Maxwell-Khor/adhd-medication-reminder/hardware/rev-c/rev-c.kicad_pcb

## KiCad design hardware/rev-c/rev-c.kicad_pcb (2026-03-25)

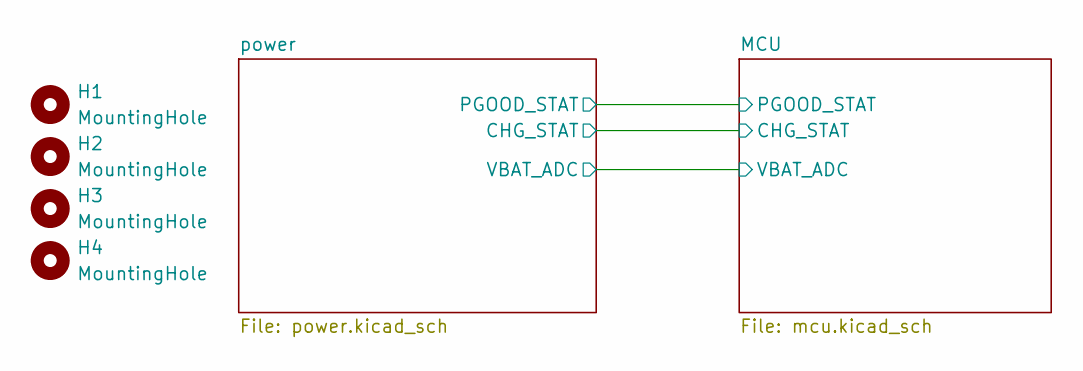
[picture p1: schematic rev-c.kicad_sch, ADHD MEDICATION REMINDER SYSTEM]

Parts:
H1, H2, H3, H4: MountingHole; MountingHole_2.2mm_M2_Pad

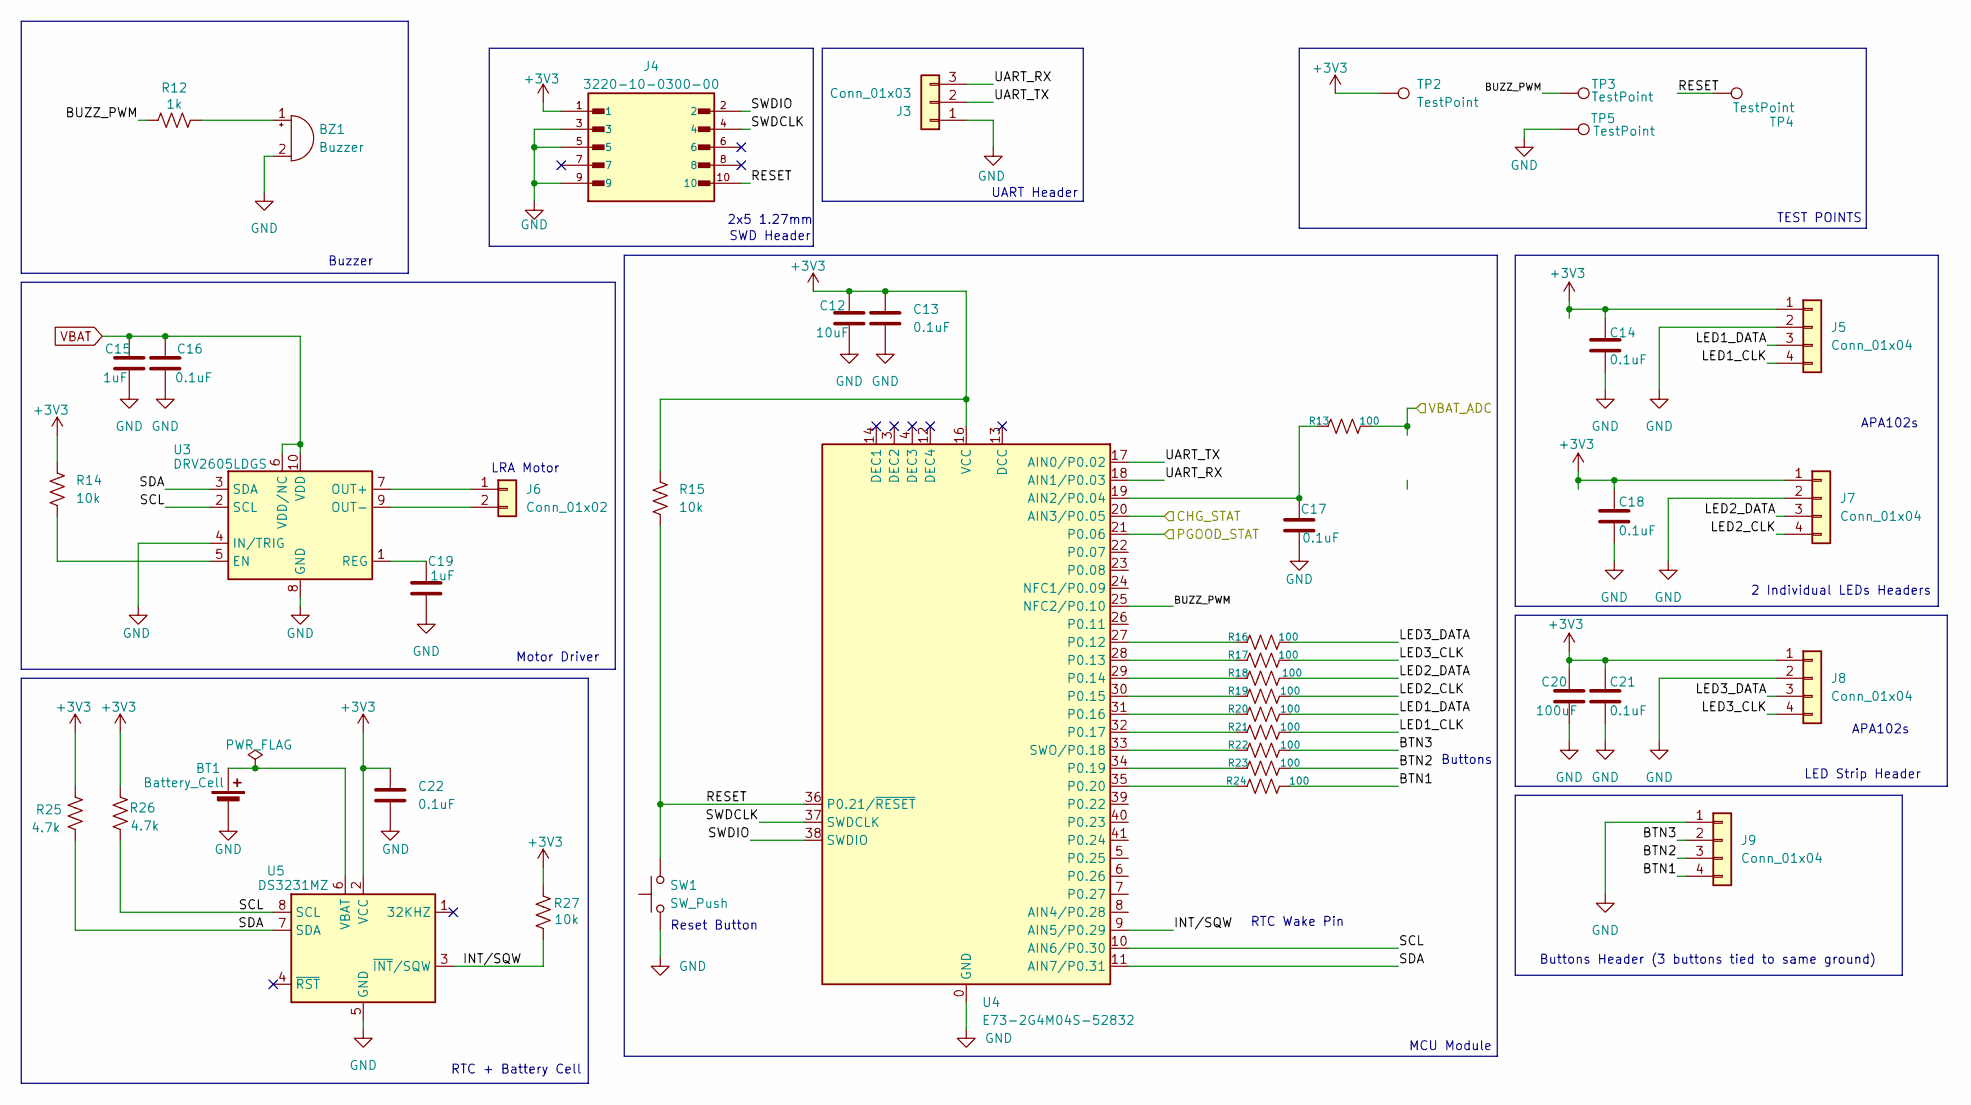
[picture p2: schematic mcu.kicad_sch, Microcontroller & Connectors]

Parts:
BT1: Battery_Cell; BatteryHolder_Keystone_3034_1x20mm
BZ1: Buzzer; XDCR_PS1240P02BT
C12: 10uF; C_0603_1608Metric
C13, C14, C16, C17, C18, C21, C22: 0.1uF; C_0603_1608Metric
C15, C19: 1uF; C_0603_1608Metric
C20: 100uF; CP_Elec_5x5.4
J3: Conn_01x03; PinHeader_1x03_P2.54mm_Vertical
J4: 3220-10-0300-00; PinHeader_2x05_P1.27mm_Vertical; PARTREV D
J5, J7, J8, J9: Conn_01x04; JST_PH_B4B-PH-K_1x04_P2.00mm_Vertical
J6: Conn_01x02; JST_PH_B2B-PH-K_1x02_P2.00mm_Vertical
R12: 1k; R_0603_1608Metric
R13, R16, R17, R18, R19, R20, R21, R22, R23, R24: 100; R_0603_1608Metric
R14, R15, R27: 10k; R_0603_1608Metric
R25, R26: 4.7k; R_0603_1608Metric
SW1: SW_Push; SW_SPST_SKQG_WithStem
TP2, TP3, TP4, TP5: TestPoint; TestPoint_Pad_D1.5mm
U3: DRV2605LDGS; VSSOP-10_3x3mm_P0.5mm
U4: E73-2G4M04S-52832; E73-2G4M04S
U5: DS3231MZ; SOIC-8_3.9x4.9mm_P1.27mm

Connections:
+3V3: C12.1, C13.1, C14.1, C18.1, C20.1, C21.1, C22.1, J4.1, J5.1, J7.1, J8.1, R14.1, R15.1, R25.2, R26.2, R27.2, TP2.1, U4.16 (VCC), U5.2 (VCC); also elsewhere on the board
/MCU/BTN1: J9.4, R24.1
/MCU/BTN2: J9.3, R23.1
/MCU/BTN3: J9.2, R22.1
/MCU/BUZZ_PWM: R12.1, TP3.1, U4.25 (NFC2/P0.10)
/MCU/CHG_STAT: U4.20 (AIN3/P0.05); also elsewhere on the board
/MCU/INT/SQW: R27.1, U4.9 (AIN5/P0.29), U5.3 (~INT/SQW)
/MCU/LED1_CLK: J5.4, R21.1
/MCU/LED1_DATA: J5.3, R20.1
/MCU/LED2_CLK: J7.4, R19.1
/MCU/LED2_DATA: J7.3, R18.2
/MCU/LED3_CLK: J8.4, R17.2
/MCU/LED3_DATA: J8.3, R16.2
/MCU/PGOOD_STAT: U4.21 (P0.06); also elsewhere on the board
/MCU/RESET: J4.10, R15.2, SW1.2, TP4.1, U4.36 (P0.21/~RESET)
/MCU/SCL: R26.1, U3.2 (SCL), U4.10 (AIN6/P0.30), U5.8 (SCL)
/MCU/SDA: R25.1, U3.3 (SDA), U4.11 (AIN7/P0.31), U5.7 (SDA)
/MCU/SWDCLK: J4.4, U4.37 (SWDCLK)
/MCU/SWDIO: J4.2, U4.38 (SWDIO)
/MCU/UART_RX: J3.3, U4.18 (AIN1/P0.03)
/MCU/UART_TX: J3.2, U4.17 (AIN0/P0.02)
/MCU/VBAT_ADC: R13.2; also elsewhere on the board
GND: BT1.2 (-), BZ1.2 (-), C12.2, C13.2, C14.2, C15.2, C16.2, C17.1, C18.2, C19.2, C20.2, C21.2, C22.2, J3.1, J4.3, J4.5, J4.9, J5.2, J7.2, J8.2, J9.1, SW1.1, TP5.1, U3.4 (IN/TRIG), U3.8 (GND), U4.0 (GND), U4.1 (GND), U4.2 (GND), U4.15 (GND), U4.42 (GND), U4.43 (GND), U5.5 (GND); also elsewhere on the board
unnamed: BT1.1 (+), U5.6 (VBAT)
unnamed: BZ1.1 (+), R12.2
unnamed: J6.1, U3.7 (OUT+)
unnamed: J6.2, U3.9 (OUT-)
unnamed: R14.2, U3.5 (EN)
unnamed: C19.1, U3.1 (REG)
unnamed: C17.2, R13.1, U4.19 (AIN2/P0.04)
unnamed: R16.1, U4.27 (P0.12)
unnamed: R17.1, U4.28 (P0.13)
unnamed: R18.1, U4.29 (P0.14)
unnamed: R19.2, U4.30 (P0.15)
unnamed: R20.2, U4.31 (P0.16)
unnamed: R21.2, U4.32 (P0.17)
unnamed: R23.2, U4.34 (P0.19)
unnamed: R24.2, U4.35 (P0.20)
unnamed: R22.2, U4.33 (SWO/P0.18)
VBAT: C15.1, C16.1, U3.6 (VDD/NC), U3.10 (VDD); also elsewhere on the board

Notes on the sheet:
LED Strip Header
MCU Module
RTC Wake Pin
RTC + Battery Cell
LRA Motor
Motor Driver
APA102s
Reset Button
UART Header
SWD Header
Buttons Header (3 buttons tied to same ground)
Buzzer
Buttons
TEST POINTS
2x5 1.27mm
2 Individual LEDs Headers

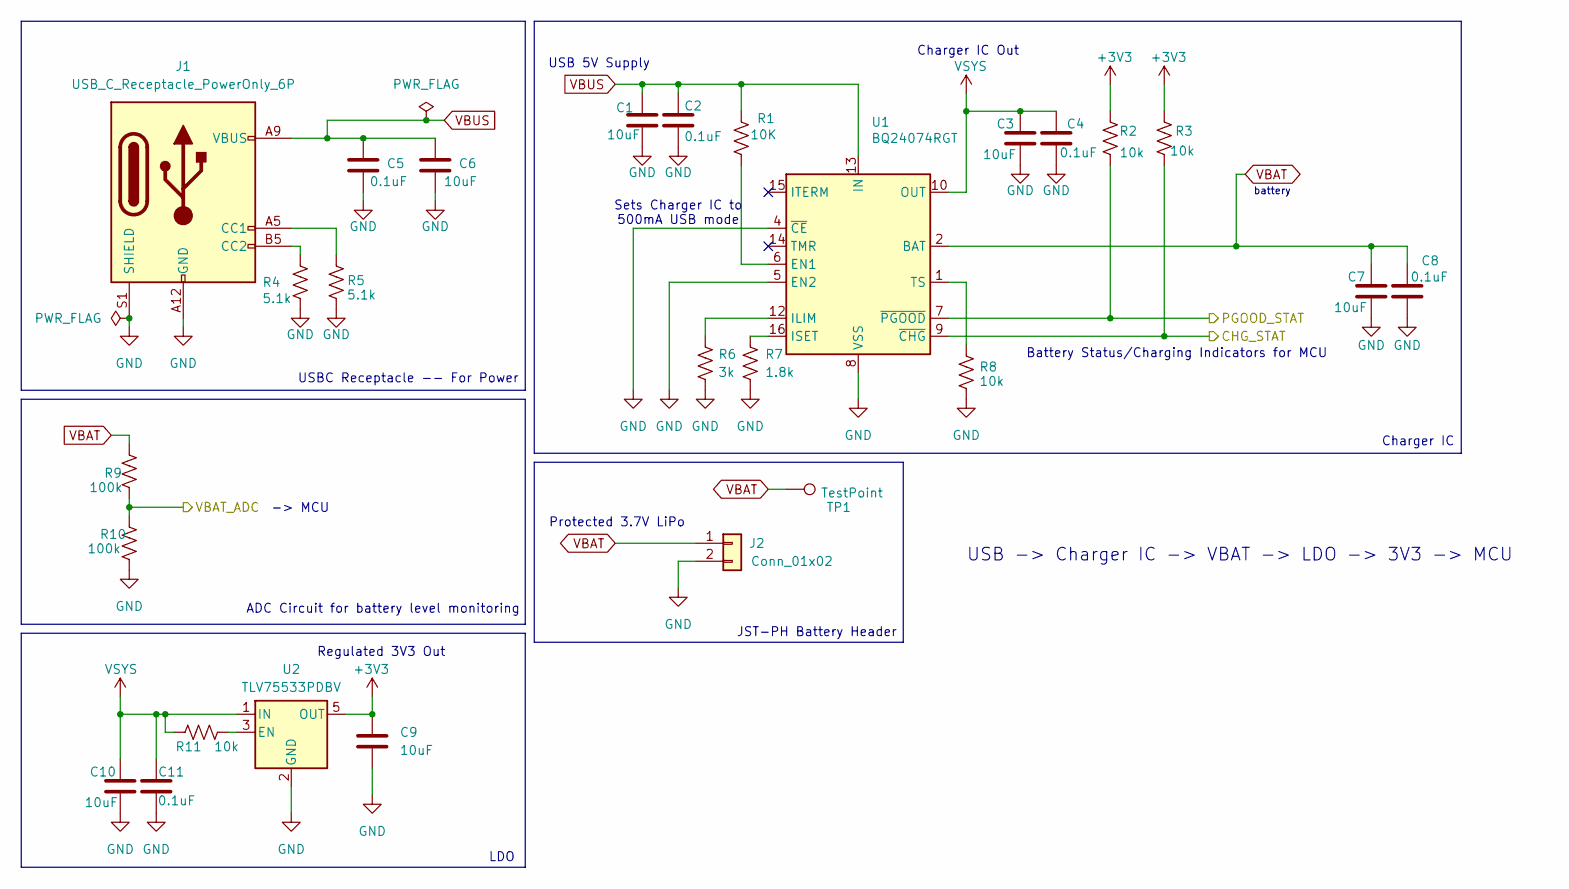
[picture p3: schematic power.kicad_sch, power sheet]

Parts:
C1, C3, C6, C7, C9, C10: 10uF; C_0603_1608Metric
C2, C4, C5, C8, C11: 0.1uF; C_0603_1608Metric
J1: USB_C_Receptacle_PowerOnly_6P; USB_C_Receptacle_HRO_TYPE-C-31-M-17
J2: Conn_01x02; JST_PH_B2B-PH-K_1x02_P2.00mm_Vertical
R1: 10K; R_0603_1608Metric
R2, R3, R8, R11: 10k; R_0603_1608Metric
R4, R5: 5.1k; R_0603_1608Metric
R6: 3k; R_0603_1608Metric
R7: 1.8k; R_0603_1608Metric
R9, R10: 100k; R_0603_1608Metric
TP1: TestPoint; TestPoint_Pad_D1.5mm
U1: BQ24074RGT; QFN-16-1EP_3x3mm_P0.5mm_EP1.7x1.7mm_ThermalVias
U2: TLV75533PDBV; SOT-23-5

Connections:
+3V3: C9.1, R2.2, R3.1, U2.5 (OUT); also elsewhere on the board
/MCU/CHG_STAT: R3.2, U1.9 (~CHG); also elsewhere on the board
/MCU/PGOOD_STAT: R2.1, U1.7 (~PGOOD); also elsewhere on the board
/MCU/VBAT_ADC: R9.1, R10.2; also elsewhere on the board
GND: C1.1, C2.1, C3.1, C4.1, C5.2, C6.2, C7.1, C8.1, C9.2, C10.1, C11.1, J1.A12 (GND), J1.B12 (GND), J1.S1 (SHIELD), J2.2, R4.2, R5.1, R6.2, R7.2, R8.2, R10.1, U1.4 (~CE), U1.5 (EN2), U1.8 (VSS), U1.17 (VSS), U2.2 (GND); also elsewhere on the board
unnamed: J1.A5 (CC1), R5.2
unnamed: J1.B5 (CC2), R4.1
unnamed: R1.1, U1.6 (EN1)
unnamed: R6.1, U1.12 (ILIM)
unnamed: R7.1, U1.16 (ISET)
unnamed: R8.1, U1.1 (TS)
unnamed: R11.2, U2.3 (EN)
VBAT: C7.2, C8.2, J2.1, R9.2, TP1.1, U1.2 (BAT), U1.3 (BAT); also elsewhere on the board
VBUS: C1.2, C2.2, C5.1, C6.1, J1.A9 (VBUS), J1.B9 (VBUS), R1.2, U1.13 (IN)
VSYS: C3.2, C4.2, C10.2, C11.2, R11.1, U1.10 (OUT), U1.11 (OUT), U2.1 (IN)

Notes on the sheet:
USBC Receptacle -- For Power
Protected 3.7V LiPo
Battery Status/Charging Indicators for MCU
JST-PH Battery Header
ADC Circuit for battery level monitoring
battery
Regulated 3V3 Out
USB -> Charger IC -> VBAT -> LDO -> 3V3 -> MCU
-> MCU
Sets Charger IC to 500mA USB mode
Charger IC
LDO
Charger IC Out
USB 5V Supply

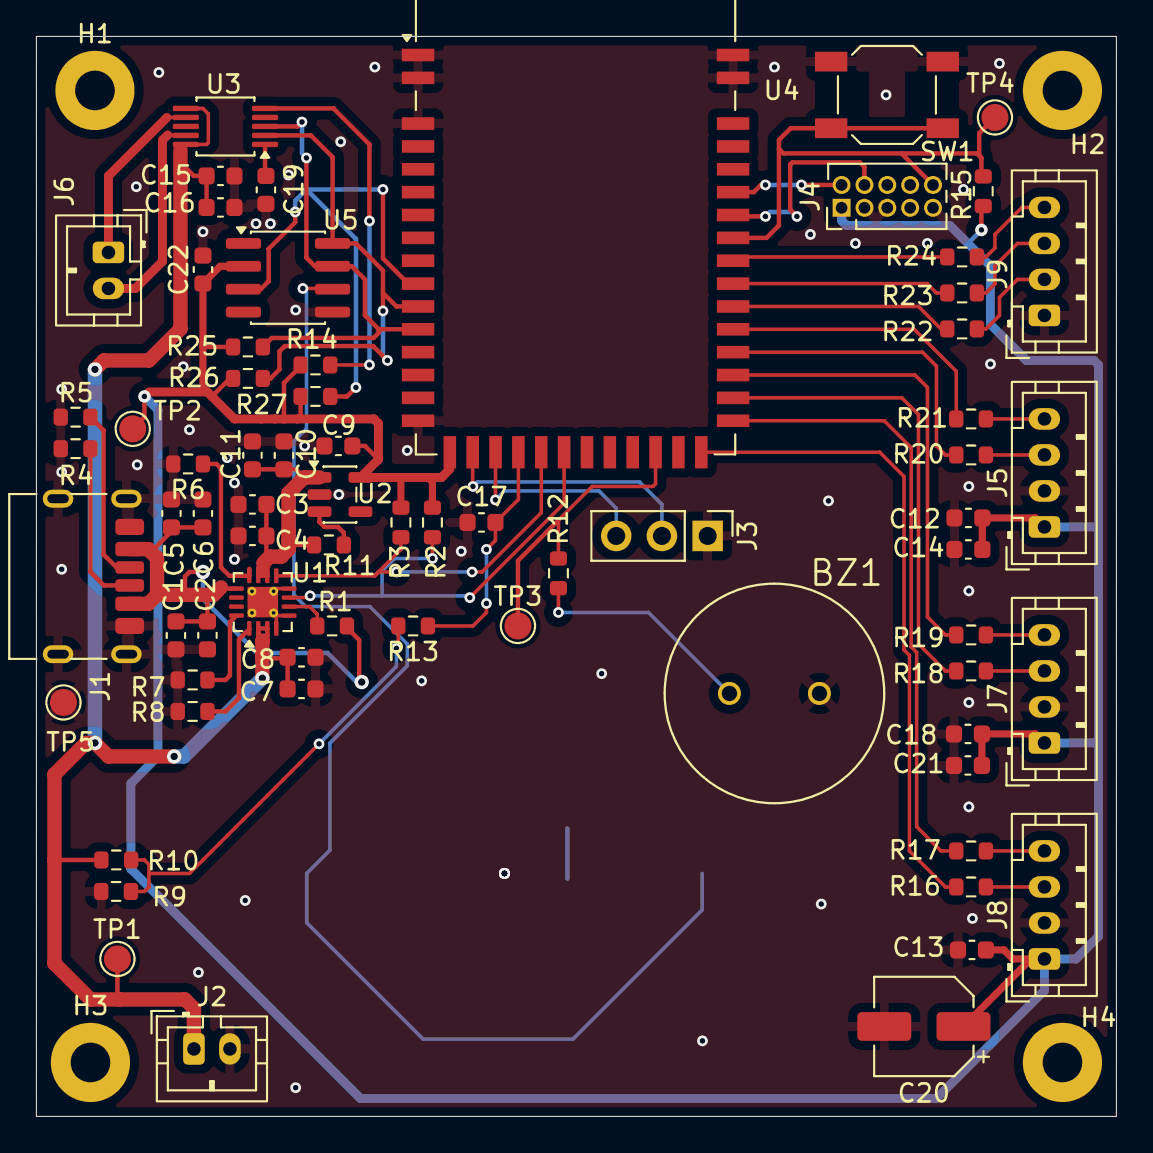
[picture p4: board rev-c.kicad_pcb from above]

Board: 2 copper layers, 60.0 x 60.0 mm, 75 parts (1 on the bottom side), 49 nets.
