Maxwell-Khor/adhd-medication-reminder/hardware/rev-b/rev-b.kicad_pcb

## KiCad design hardware/rev-b/rev-b.kicad_pcb (2026-03-23, an earlier design)


Parts:
H1, H2, H3, H4: MountingHole; MountingHole_2.2mm_M2_Pad

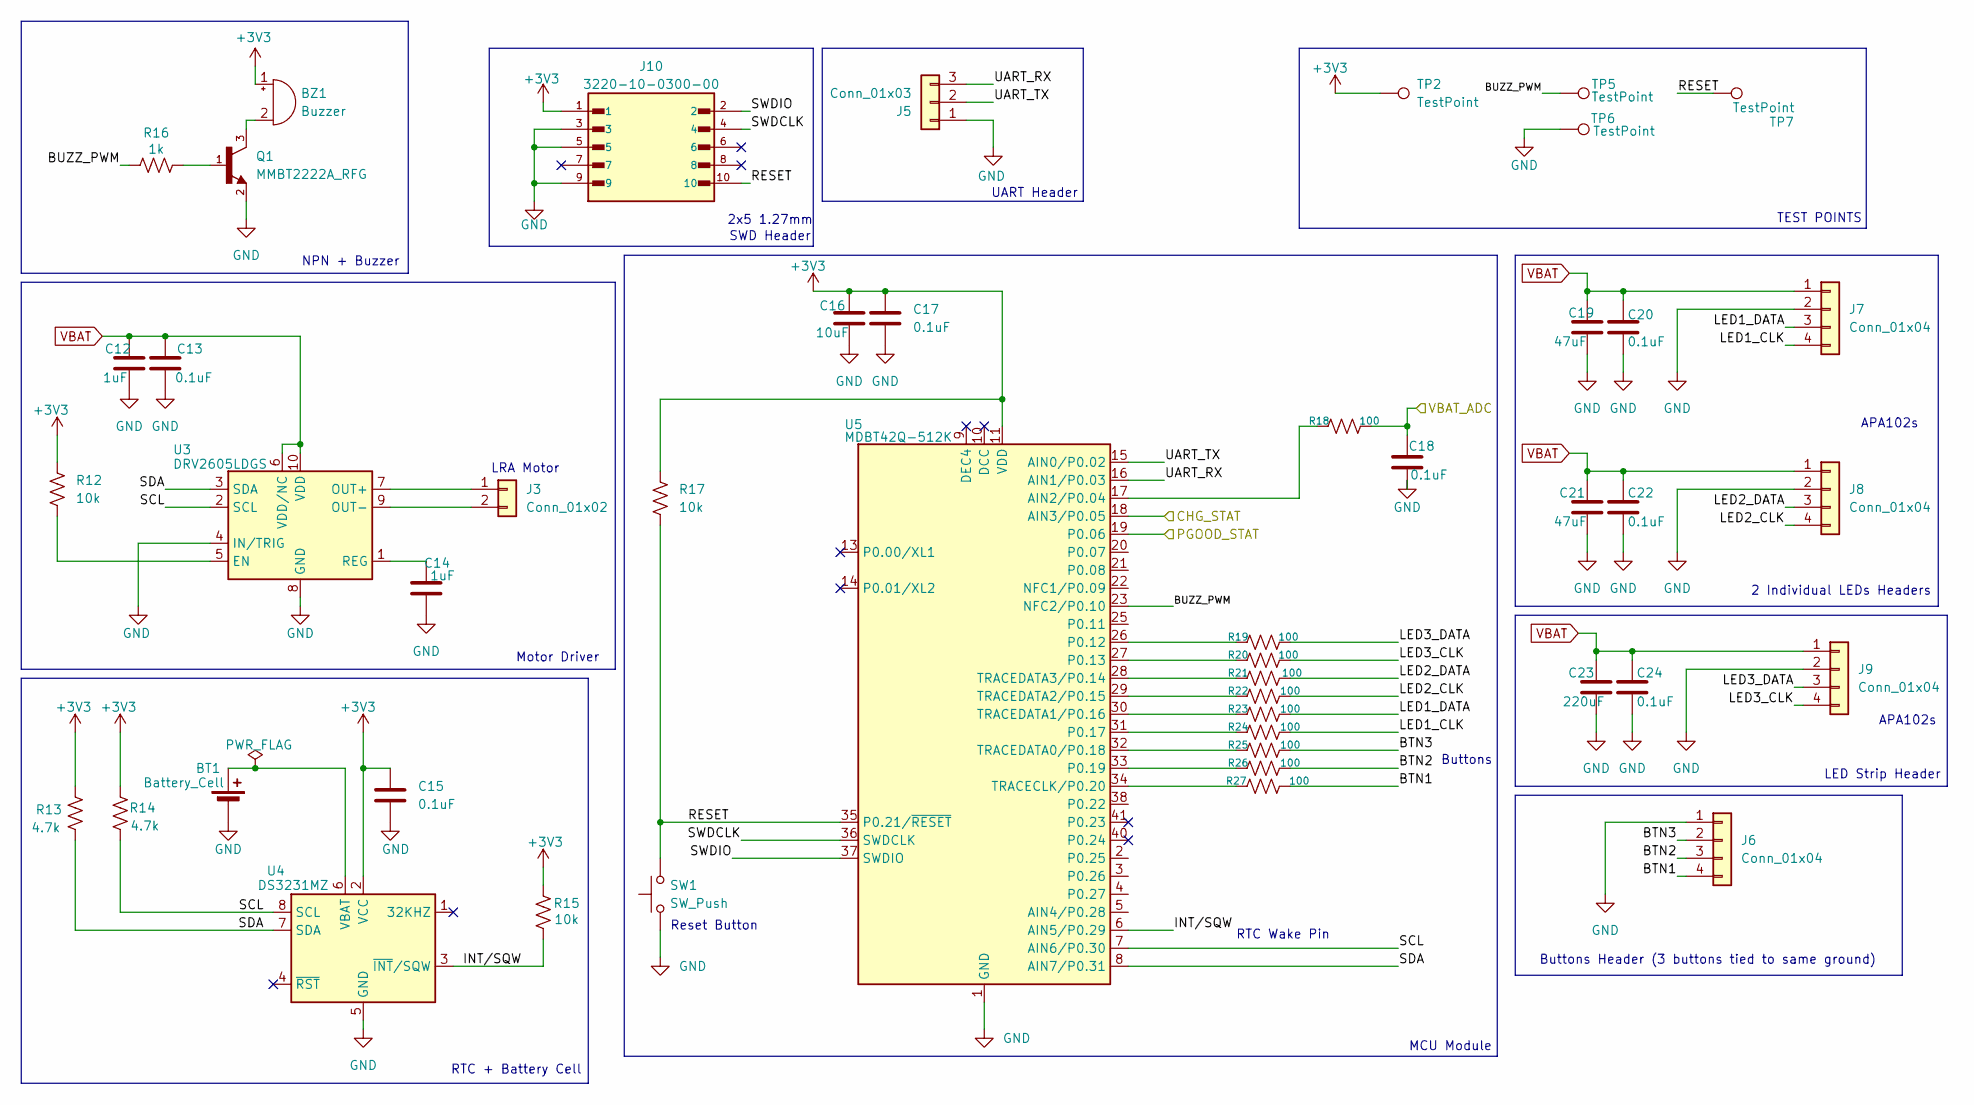
[picture p5: schematic mcu.kicad_sch, Microcontroller & Connectors]

Parts:
BT1: Battery_Cell; BatteryHolder_Keystone_3034_1x20mm
BZ1: Buzzer; CUI_CMT-1203-SMT
C12, C14: 1uF; C_0603_1608Metric
C13, C15, C17, C18, C20, C22, C24: 0.1uF; C_0603_1608Metric
C16: 10uF; C_0603_1608Metric
C19, C21: 47uF; C_0603_1608Metric
C23: 220uF; CP_Elec_5x5.3
J3: Conn_01x02; JST_PH_B2B-PH-K_1x02_P2.00mm_Vertical
J5: Conn_01x03; PinHeader_1x03_P2.54mm_Vertical
J6, J7, J8, J9: Conn_01x04; JST_PH_B4B-PH-K_1x04_P2.00mm_Vertical
J10: 3220-10-0300-00; PinHeader_2x05_P1.27mm_Vertical; PARTREV D
Q1: MMBT2222A_RFG; SOT-23; PARTREV I2001
R12, R15, R17: 10k; R_0603_1608Metric
R13, R14: 4.7k; R_0603_1608Metric
R16: 1k; R_0603_1608Metric
R18, R19, R20, R21, R22, R23, R24, R25, R26, R27: 100; R_0603_1608Metric
SW1: SW_Push; SW_SPST_EVQP0
TP2, TP5, TP6, TP7: TestPoint; TestPoint_Pad_D1.5mm
U3: DRV2605LDGS; VSSOP-10_3x3mm_P0.5mm
U4: DS3231MZ; SOIC-8_3.9x4.9mm_P1.27mm
U5: MDBT42Q-512K; Raytac_MDBT42Q

Connections:
+3V3: BZ1.1 (+), C15.1, C16.1, C17.1, J10.1, R12.1, R13.2, R14.2, R15.2, R17.1, TP2.1, U4.2 (VCC), U5.11 (VDD); also elsewhere on the board
/MCU/BTN1: J6.4, R27.1
/MCU/BTN2: J6.3, R26.1
/MCU/BTN3: J6.2, R25.1
/MCU/BUZZ_PWM: R16.1, TP5.1, U5.23 (NFC2/P0.10)
/MCU/CHG_STAT: U5.18 (AIN3/P0.05); also elsewhere on the board
/MCU/INT/SQW: R15.1, U4.3 (~INT/SQW), U5.6 (AIN5/P0.29)
/MCU/LED1_CLK: J7.4, R24.1
/MCU/LED1_DATA: J7.3, R23.1
/MCU/LED2_CLK: J8.4, R22.1
/MCU/LED2_DATA: J8.3, R21.2
/MCU/LED3_CLK: J9.4, R20.2
/MCU/LED3_DATA: J9.3, R19.2
/MCU/PGOOD_STAT: U5.19 (P0.06); also elsewhere on the board
/MCU/RESET: J10.10, R17.2, SW1.2, TP7.1, U5.35 (P0.21/~RESET)
/MCU/SCL: R14.1, U3.2 (SCL), U4.8 (SCL), U5.7 (AIN6/P0.30)
/MCU/SDA: R13.1, U3.3 (SDA), U4.7 (SDA), U5.8 (AIN7/P0.31)
/MCU/SWDCLK: J10.4, U5.36 (SWDCLK)
/MCU/SWDIO: J10.2, U5.37 (SWDIO)
/MCU/UART_RX: J5.3, U5.16 (AIN1/P0.03)
/MCU/UART_TX: J5.2, U5.15 (AIN0/P0.02)
/MCU/VBAT_ADC: C18.2, R18.2; also elsewhere on the board
GND: BT1.2 (-), C12.2, C13.2, C14.2, C15.2, C16.2, C17.2, C18.1, C19.2, C20.2, C21.2, C22.2, C23.2, C24.2, J5.1, J6.1, J7.2, J8.2, J9.2, J10.3, J10.5, J10.9, Q1.2, SW1.1, TP6.1, U3.4 (IN/TRIG), U3.8 (GND), U4.5 (GND), U5.1 (GND), U5.12 (GND), U5.24 (GND), U5.39 (GND); also elsewhere on the board
unnamed: BT1.1 (+), U4.6 (VBAT)
unnamed: BZ1.2 (-), Q1.3
unnamed: J3.1, U3.7 (OUT+)
unnamed: J3.2, U3.9 (OUT-)
unnamed: Q1.1, R16.2
unnamed: R12.2, U3.5 (EN)
unnamed: C14.1, U3.1 (REG)
unnamed: R18.1, U5.17 (AIN2/P0.04)
unnamed: R19.1, U5.26 (P0.12)
unnamed: R20.1, U5.27 (P0.13)
unnamed: R24.2, U5.31 (P0.17)
unnamed: R26.2, U5.33 (P0.19)
unnamed: R27.2, U5.34 (TRACECLK/P0.20)
unnamed: R25.2, U5.32 (TRACEDATA0/P0.18)
unnamed: R23.2, U5.30 (TRACEDATA1/P0.16)
unnamed: R22.2, U5.29 (TRACEDATA2/P0.15)
unnamed: R21.1, U5.28 (TRACEDATA3/P0.14)
VBAT: C12.1, C13.1, C19.1, C20.1, C21.1, C22.1, C23.1, C24.1, J7.1, J8.1, J9.1, U3.6 (VDD/NC), U3.10 (VDD); also elsewhere on the board

Notes on the sheet:
LED Strip Header
MCU Module
RTC Wake Pin
RTC + Battery Cell
LRA Motor
Motor Driver
APA102s
Reset Button
UART Header
SWD Header
Buttons Header (3 buttons tied to same ground)
NPN + Buzzer
Buttons
TEST POINTS
2x5 1.27mm
2 Individual LEDs Headers

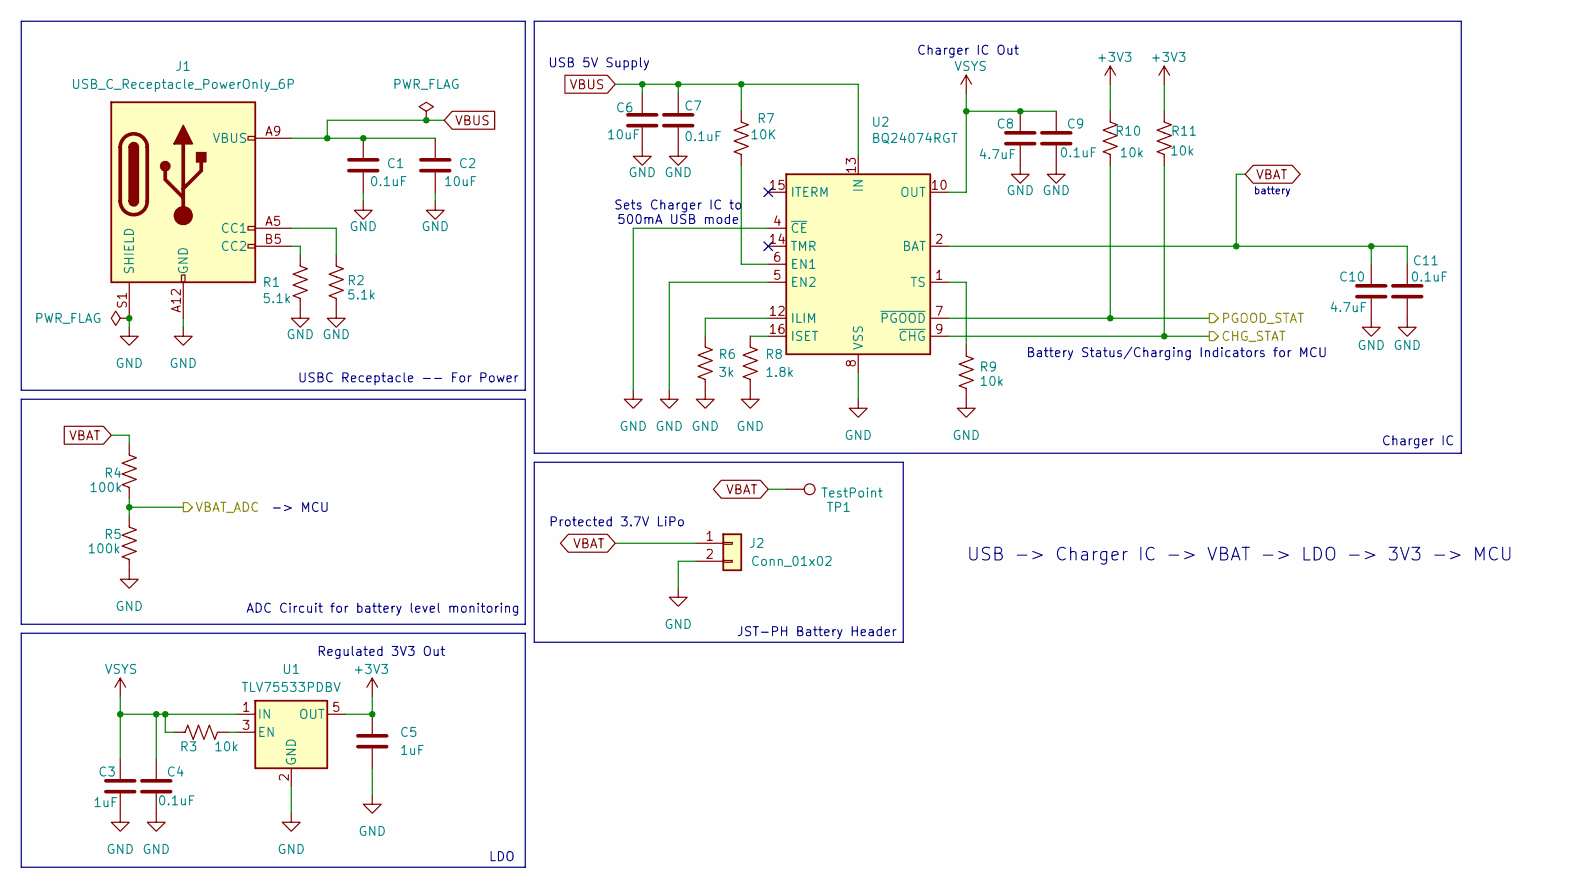
[picture p6: schematic power.kicad_sch, power sheet]

Parts:
C1, C4, C7, C9, C11: 0.1uF; C_0603_1608Metric
C2, C6: 10uF; C_0603_1608Metric
C3, C5: 1uF; C_0603_1608Metric
C8, C10: 4.7uF; C_0603_1608Metric
J1: USB_C_Receptacle_PowerOnly_6P; GCT_USB4125-GF-A_REVA2
J2: Conn_01x02; JST_PH_B2B-PH-K_1x02_P2.00mm_Vertical
R1, R2: 5.1k; R_0603_1608Metric
R3, R9, R10, R11: 10k; R_0603_1608Metric
R4, R5: 100k; R_0603_1608Metric
R6: 3k; R_0603_1608Metric
R7: 10K; R_0603_1608Metric
R8: 1.8k; R_0603_1608Metric
TP1: TestPoint; TestPoint_Pad_D1.5mm
U1: TLV75533PDBV; SOT-23-5
U2: BQ24074RGT; QFN-16-1EP_3x3mm_P0.5mm_EP1.7x1.7mm_ThermalVias

Connections:
+3V3: C5.1, R10.2, R11.1, U1.5 (OUT); also elsewhere on the board
/MCU/CHG_STAT: R11.2, U2.9 (~CHG); also elsewhere on the board
/MCU/PGOOD_STAT: R10.1, U2.7 (~PGOOD); also elsewhere on the board
/MCU/VBAT_ADC: R4.1, R5.2; also elsewhere on the board
GND: C1.2, C2.2, C3.1, C4.1, C5.2, C6.1, C7.1, C8.1, C9.1, C10.1, C11.1, J1.A12 (GND), J1.B12 (GND), J1.S1 (SHIELD), J2.2, R1.2, R2.1, R5.1, R6.2, R8.2, R9.2, U1.2 (GND), U2.4 (~CE), U2.5 (EN2), U2.8 (VSS), U2.17 (VSS); also elsewhere on the board
unnamed: J1.A5 (CC1), R2.2
unnamed: J1.B5 (CC2), R1.1
unnamed: R3.2, U1.3 (EN)
unnamed: R7.1, U2.6 (EN1)
unnamed: R6.1, U2.12 (ILIM)
unnamed: R8.1, U2.16 (ISET)
unnamed: R9.1, U2.1 (TS)
VBAT: C10.2, C11.2, J2.1, R4.2, TP1.1, U2.2 (BAT), U2.3 (BAT); also elsewhere on the board
VBUS: C1.1, C2.1, C6.2, C7.2, J1.A9 (VBUS), J1.B9 (VBUS), R7.2, U2.13 (IN)
VSYS: C3.2, C4.2, C8.2, C9.2, R3.1, U1.1 (IN), U2.10 (OUT), U2.11 (OUT)

Notes on the sheet:
USBC Receptacle -- For Power
Protected 3.7V LiPo
Battery Status/Charging Indicators for MCU
JST-PH Battery Header
ADC Circuit for battery level monitoring
battery
Regulated 3V3 Out
USB -> Charger IC -> VBAT -> LDO -> 3V3 -> MCU
-> MCU
Sets Charger IC to 500mA USB mode
Charger IC
LDO
Charger IC Out
USB 5V Supply

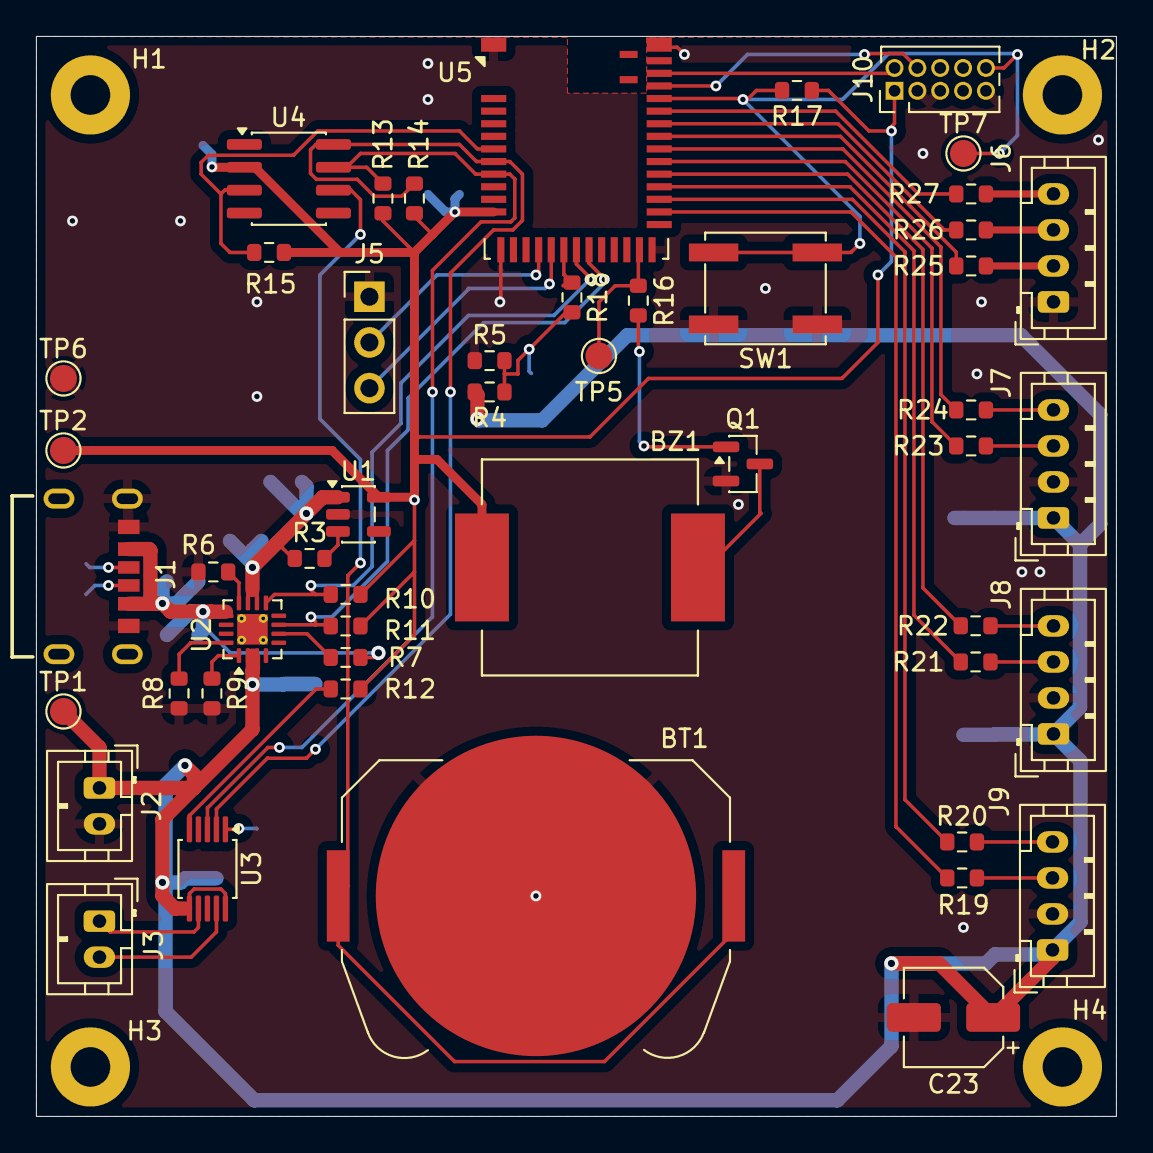
[picture p7: board rev-b.kicad_pcb from above]

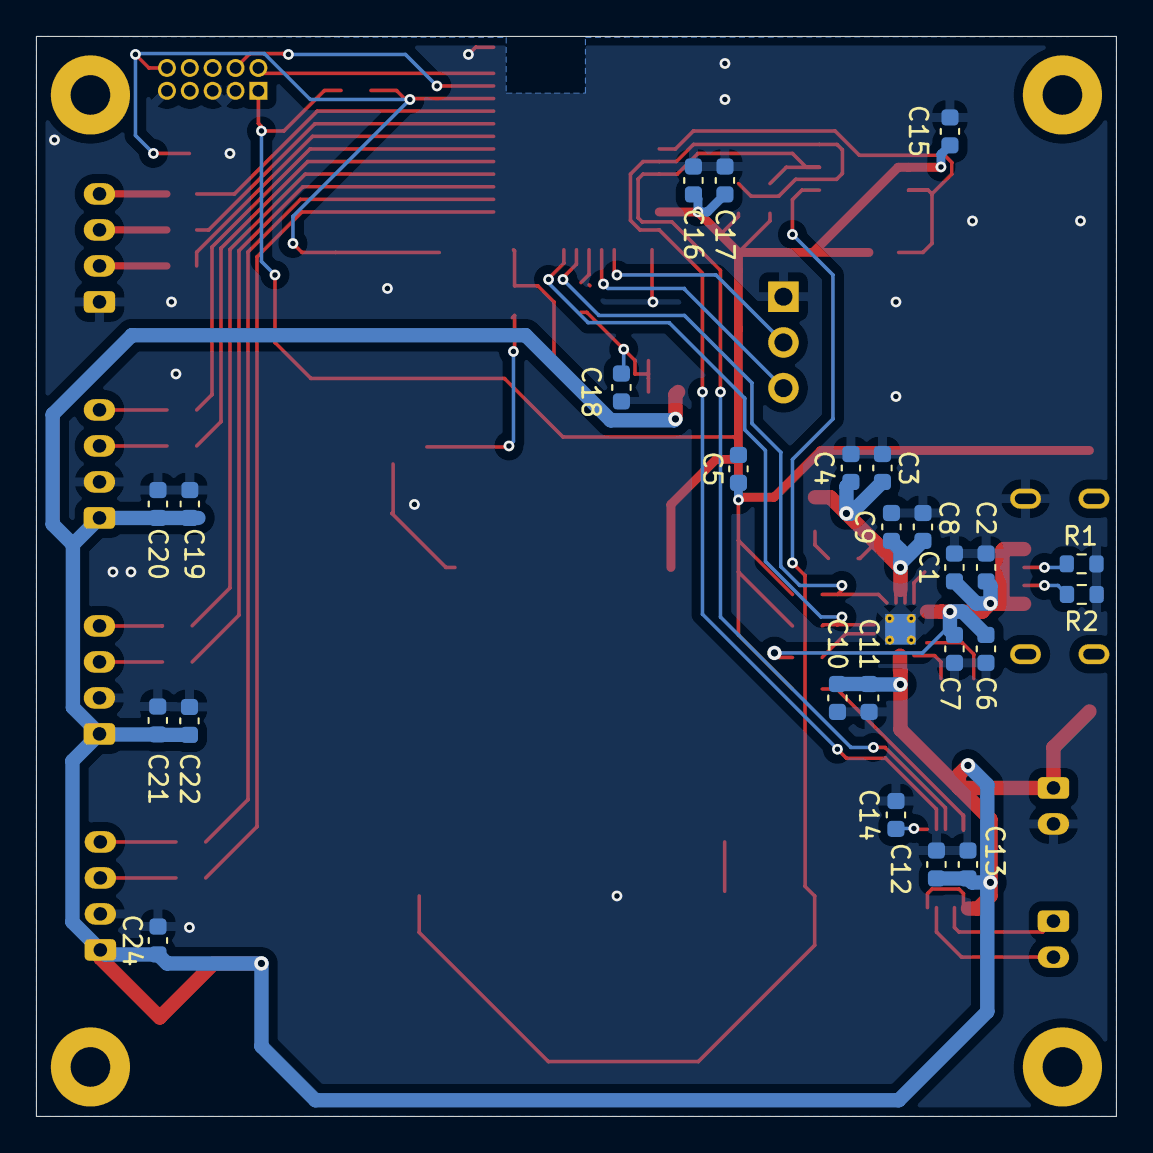
[picture p8: board rev-b.kicad_pcb from below]

Board: 2 copper layers, 60.0 x 60.0 mm, 78 parts (25 on the bottom side), 50 nets.
