Maxwell-Khor/adhd-medication-reminder/(commit log)

2026-03-10 Add ADHD PCB V1 hardware project
    [adhdv1.00.kicad_pcb, adhdv1.00.kicad_sch]
2026-03-10 Rename hardware revision to rev-a
    [adhdv1.00.kicad_pcb, adhdv1.00.kicad_sch]
2026-03-11 Create power and MCU hierarchal pages
    [adhdv1.00.kicad_sch, mcu.kicad_sch, power.kicad_sch]
2026-03-13 finalize MCU sheet and add haptic feedback sheet
    [adhdv1.00.kicad_sch, mcu.kicad_sch, motor.kicad_sch, power.kicad_sch]
2026-03-13 Annotate schematic hierarchy and fix LED routing
    [adhdv1.00.kicad_sch, mcu.kicad_sch, power.kicad_sch]
2026-03-13 rev: schematic revision B
    [adhdv1.00.kicad_sch, mcu.kicad_sch, power.kicad_sch]
2026-03-15 intialize PCB layout document
    [adhdv1.00.kicad_pcb, mcu.kicad_sch, power.kicad_sch]
2026-03-18 Assign footprints and add additional bypass caps
    [adhdv1.00.kicad_sch, mcu.kicad_sch, power.kicad_sch]
2026-03-18 updated layout from schematic
    [adhdv1.00.kicad_pcb, power.kicad_sch]
2026-03-20 format schematic to fit convention, replace SWD header with 2x5
    [adhdv1.00.kicad_pcb, adhdv1.00.kicad_sch, mcu.kicad_sch, power.kicad_sch]
2026-03-20 rev c with labeled ICs
    [adhdv1.00.kicad_sch, mcu.kicad_sch, power.kicad_sch]
2026-03-22 crackhead layout file added
    [adhdv1.00.kicad_pcb, mcu.kicad_sch, power.kicad_sch]
2026-03-23 plot fab and assembly files
    [adhdv2.00.kicad_pcb, mcu.kicad_sch, motor.kicad_sch, power.kicad_sch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]
2026-03-25 rev c layout complete
    [mcu.kicad_sch, power.kicad_sch, rev-c.kicad_pcb, rev-c.kicad_sch]
